STARS-Design-Track-2023/MatrixMonSTARS/docs/pdfs/OpcodeDecoder.drawio.pdf

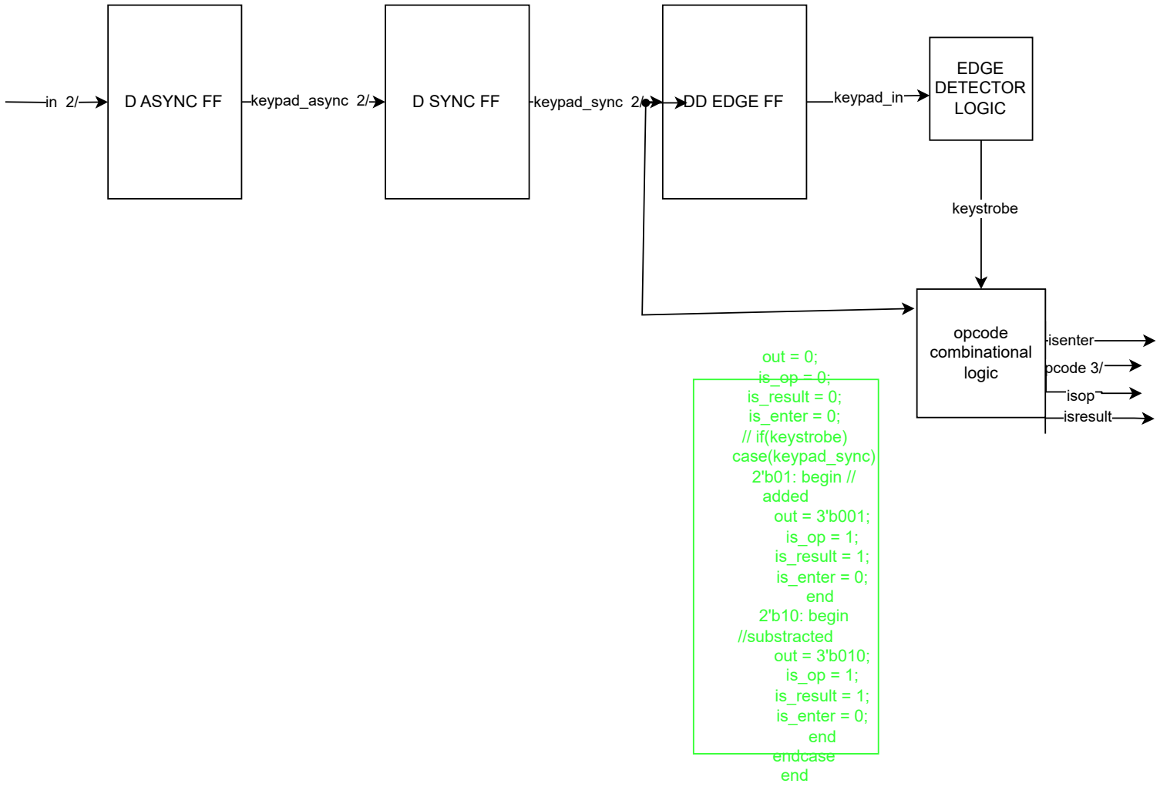
[picture p5: figure]
D ASYNC FF; keypad_async 2/; D SYNC FF; keypad_sync 2/; DD EDGE FF; keypad_in; out = 0; is_op = 0; is_result = 0; is_enter = 0; // if(keystrobe) case(keypad_sync) 2'b01: begin // added out = 3'b001; is_op = 1; is_result = 1; is_enter = 0; end 2'b10: begin //substracted out = 3'b010; is_op = 1; is_result = 1; is_enter = 0; end endcase end; opcode 3/; isop isresult; isenter opcode combinational logic; keystrobe; EDGE DETECTOR LOGIC
