STARS-Design-Track-2023/MatrixMonSTARS/docs/pdfs/ssdec.drawio.pdf

Seven Segment Decode Logic: case(msd)
4'b0000: begin
segments[13:7] =
7'b01

1

1

1

11;
end
4'b0001: begin segments[13:7] = 7'b0000110;
end
4'b0010: begin segments[13:7] = 7'b1011011;
end
4'b0011: begin segments[13:7] = 7'b1001

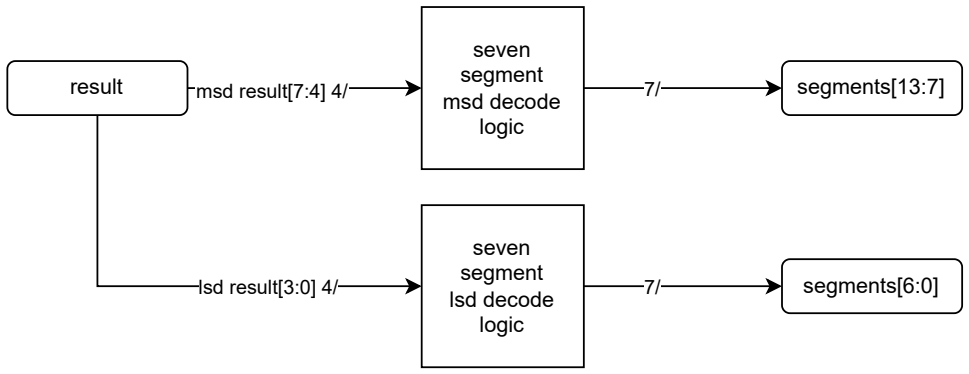
[picture p6: figure]
seven segment msd decode logic; msd result[7:4] 4/ result; segments[13:7]; seven segment lsd decode logic; lsd result[3:0] 4/; segments[6:0]

1

11;
end
4'b0100: begin segments[13:7] = 7'b1100110;
end
4'b0101: begin segments[13:7] = 7'b1101101;
end
4'b0110: begin segments[13:7] = 7'b1

1

1

1101;
end
4'b01

11: begin segments[13:7]
= 7'b00001

11;
end
4'b1000: begin segments[13:7] = 7'b1

1

1

1

1

11;
end
4'b1001: begin segments[13:7] = 7'b1101

1

11;
end
default: begin segments[13:7] = 7'b0;
end
endcase

Note: Although the least
significant digit is not shown here. The cases are identical
