STARS-Design-Track-2023/MatrixMonSTARS/docs/manual.pdf

# Setting up the Calculator

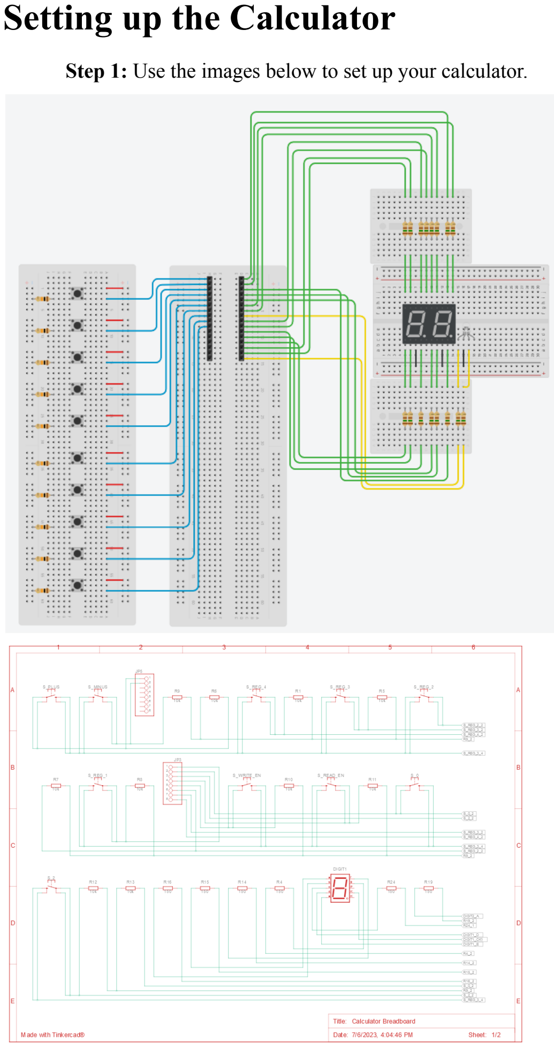
[picture p7: page 1]

Step 1: Use the images below to set up your calculator.

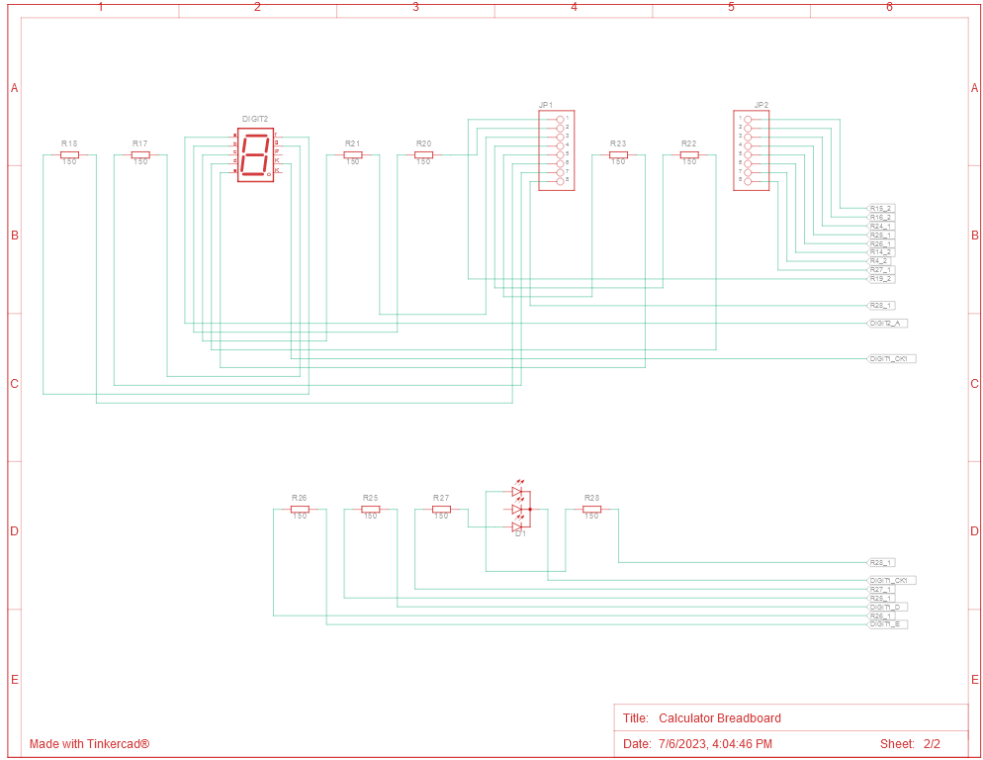
[picture p8: figure]

# How To Use the Calculator

This Calculator only supports 1 and 0s as inputs. All inputs must be in the form of a binary coded decimal (BCD). The BCD and decimal equivalent are listed below:

0 --> 000000000 | 1 --> 000000001 | 2 --> 000000010 | 3 --> 000000011
4 --> 000000100 | 5 --> 000000101 | 6 --> 000000110 | 7 --> 000000111
8 --> 000001000 | 9 --> 000011001 | 10 --> 000010000 | 11 --> 000010001
12 --> 000010010 | 13 --> 000010011 | 14 --> 000010100 | 15 --> 000010101
16 --> 000010110 | 17 --> 000010111 | 18 --> 000011000 | 19 --> 000101001
20 --> 000100000 | 21 --> 000100001 | 22 --> 000100010 | 23 --> 000100011
24 --> 000100100 | 25 --> 000100101 | 26 --> 000100110 | 27 --> 000100111
28 --> 000101000 | 29 --> 000111001 | 30 --> 000110000 | 31 --> 000110001
32 --> 000110010 | 33 --> 000110011 | 34 --> 000110100 | 35 --> 000110101
76 --> 001110110 | 77 --> 001110111 | 78 --> 001111000 | 79 --> 010001001
80 --> 010000000 | 81 --> 010000001 | 82 --> 010000010 | 83 --> 010000011
84 --> 010000100 | 85 --> 010000101 | 86 --> 010000110 | 87 --> 010000111
88 --> 010001000 | 89 --> 010011001 | 90 --> 010010000 | 91 --> 010010001
92 --> 010010010 | 93 --> 010010011 | 94 --> 010010100 | 95 --> 010010101
96 --> 010010110 | 97 --> 010010111 | 98 --> 010011000 | 99 --> 010011001
-100 --> 100000000 -99 --> 100000001 | -98 --> 100000010 | -97 --> 100000011
-96 --> 100000100 | -95 --> 100000101 | -94 --> 100000110 | -93 --> 100000111
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

Step 1: Entering the numbers into the calculator
When you first power up the calculator, you will need to press the enable button to start the process of writing the BCD values into the calculator’s memory. The write enable button is shown in the image below.

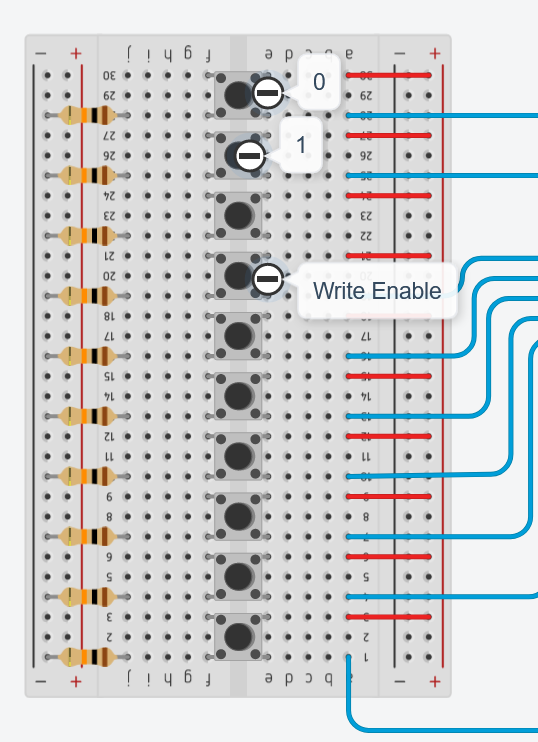
[picture p9: figure]

When the write enable has been pressed, enter your number using the 0 and 1 button. If the number you entered shows up on the seven segment displays, you have done it correctly. If you get an unexpected display, you may have made a mistake. If you have, please restart the calculator and start Step 1 again.

Step 2: Storing the numbers
This calculator has a register file that can store up to four digits. To store a number press any of the four registers. Note: Any value that is currently stored in the register will be overwritten with the most recent value entered. The register buttons are shown in the image below. You do not need to fill all the registers. You only need at least two to make calculations.

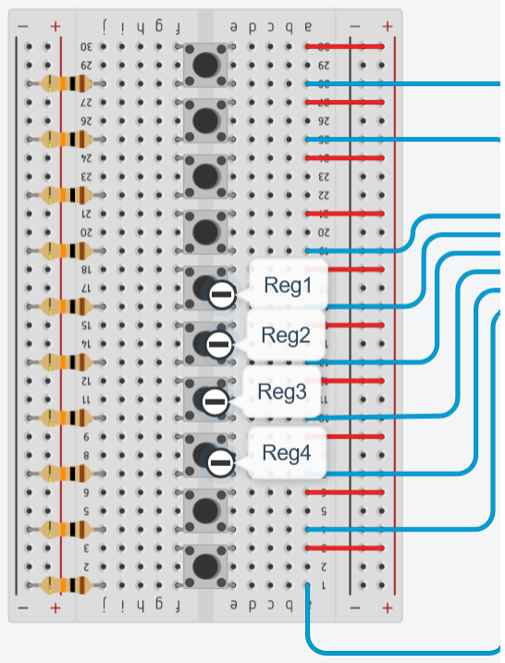
[picture p10: figure]

Step 3: Doing the calculation
When you have finished storing the numbers, to do the calculation, press the read enable button. This enables the calculator to read values from the shift register. When you have pressed the read enable button, select any two values by pressing the register buttons you would like to calculate. When you have done so, simply press the addition or subtraction button to get your calculations. The relevant buttons are shown in the image below.

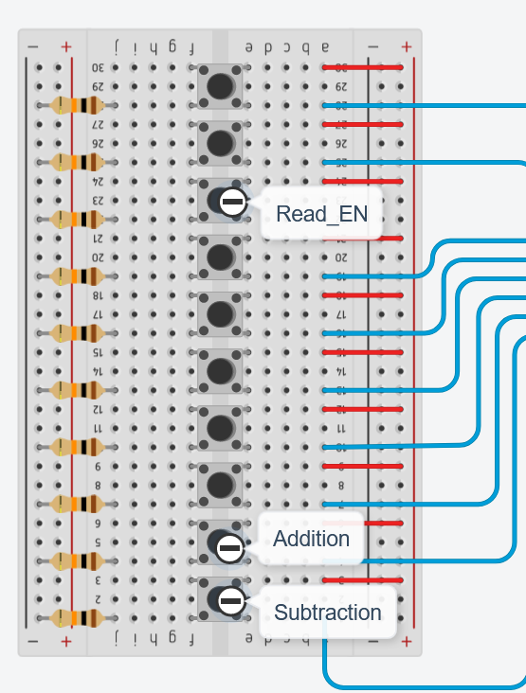
[picture p11: figure]

# Making Another Calculation Using Values Entered

If you have entered four values and you want to make a calculation using those numbers simply repeat Step 3 after you get your result.

# Entering New Numbers

To enter new numbers, simply press the write enable button and start from Step 1.
