STARS-Design-Track-2023/MatrixMonSTARS/docs/pdfs/readFSM.drawio-1.pdf

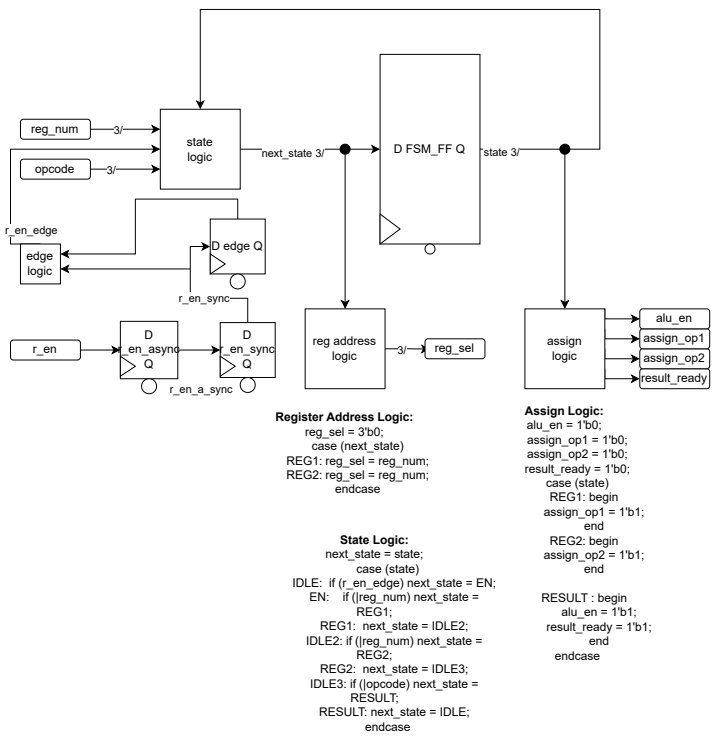
[picture p12: page 1]
state logic; D FSM_FF Q; state 3/; assign logic; result_ready; assign_op2; assign_op1; alu_en; reg address logic; next_state 3/; reg_sel; opcode; reg_num; State Logic: next_state = state; case (state); REG1; REG1: next_state = IDLE2; IDLE2: if (|reg_num) next_state = REG2; REG2: next_state = IDLE3; IDLE3: if (|opcode) next_state = RESULT; RESULT: next_state = IDLE; endcase; Register Address Logic: reg_sel = 3'b0; case (next_state) REG1: reg_sel = reg_num; REG2: reg_sel = reg_num; endcase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

IDLE: if (r_en_edge) next_state = EN;
EN: if (|reg_num) next_state =
