STARS-Design-Track-2023/MatrixMonSTARS/docs/pdfs/Reg_Decoder.drawio.pdf

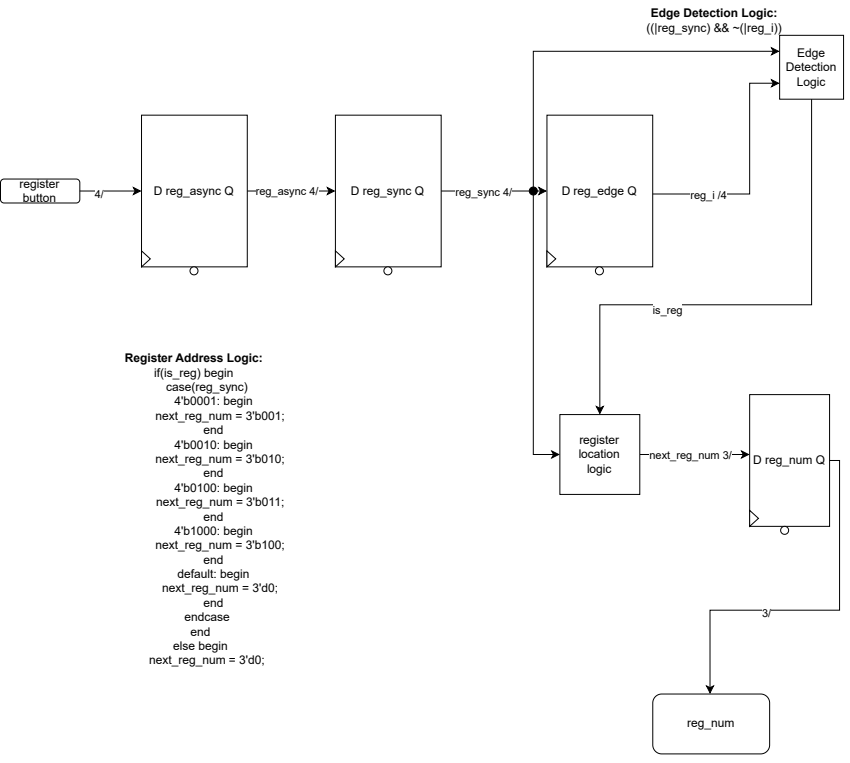
[picture p13: page 1]
register; button; D reg_async Q; reg_async 4/; D reg_sync Q; reg_sync 4/; D reg_edge Q; is_reg; Edge Detection Logic; reg_i /4; next_reg_num 3/; register location logic; D reg_num Q; reg_num; Register Address Logic: if(is_reg) begin case(reg_sync) 4'b0001: begin next_reg_num = 3'b001; end 4'b0010: begin next_reg_num = 3'b010; end 4'b0100: begin next_reg_num = 3'b011; end 4'b1000: begin next_reg_num = 3'b100; end default: begin next_reg_num = 3'd0; end endcase end else begin next_reg_num = 3'd0;

Edge Detection Logic:
((|reg_sync) && ~(|reg_i))
