STARS-Design-Track-2023/MatrixMonSTARS/docs/pdfs/Top Module.drawio.pdf

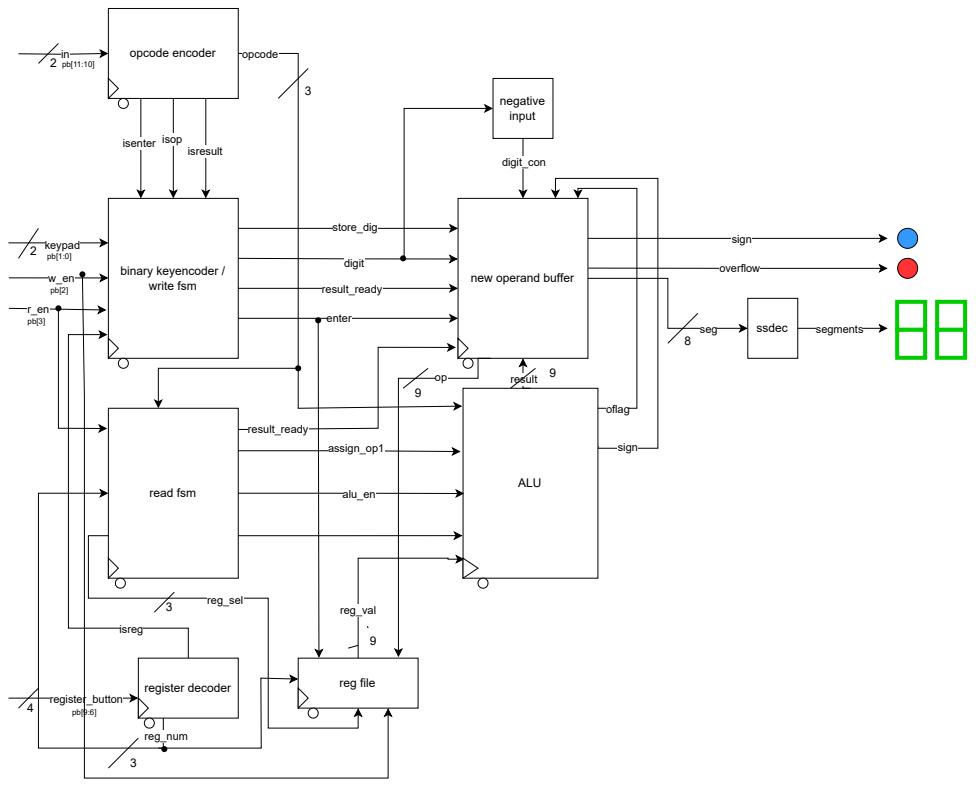
[picture p14: page 1]
store_dig; result_ready; negative input; isop isenter; isresult; opcode encoder; opcode; sign; enter; digit_con; reg_num; isreg; register decoder; reg file; read fsm; reg_sel; oflag; ALU; result; reg_val; alu_en; assign_op1; ssdec; segments; keypad; seg; register_button; overflow

digit binary keyencoder /
write fsm

new operand buffer
