STARS-Design-Track-2023/MatrixMonSTARS/docs/pdfs/NewOperandBuffer.drawio.pdf

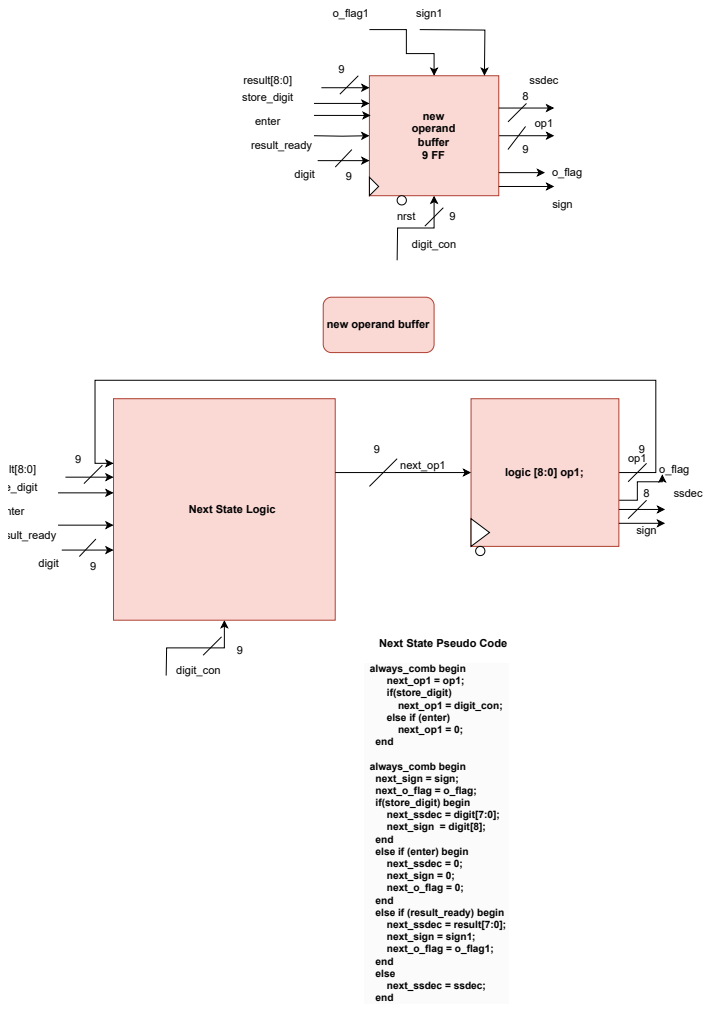
[picture p17: page 1]
new operand buffer 9 FF; digit; nrst; store_digit; result_ready; logic [8:0] op1;; next_op1; result[8:0]; sign; enter; ssdec; o_flag1; sign1; o_flag; e_digit; sult_ready; nter; digit_con; always_comb begin next_op1 = op1; if(store_digit) next_op1 = digit_con; else if (enter) next_op1 = 0;; end; always_comb begin next_sign = sign; next_o_flag = o_flag; if(store_digit) begin next_ssdec = digit[7:0]; next_sign = digit[8]; end else if (enter) begin next_ssdec = 0; next_sign = 0; next_o_flag = 0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

new operand buffer

Next State Logic

Next State Pseudo Code
