STARS-Design-Track-2023/MatrixMonSTARS/docs/pdfs/readFSM_State_Transision.drawio.pdf

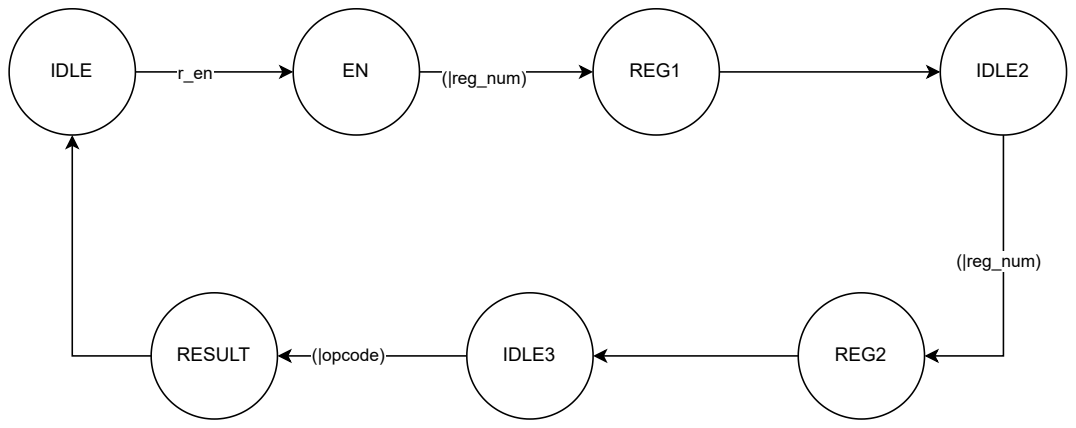
[picture p18: page 1]
IDLE; (|reg_num) EN; REG1; (|reg_num); IDLE2; RESULT; (|opcode); IDLE3; REG2
