STARS-Design-Track-2023/MatrixMonSTARS/docs/pdfs/reg_file.drawio.pdf

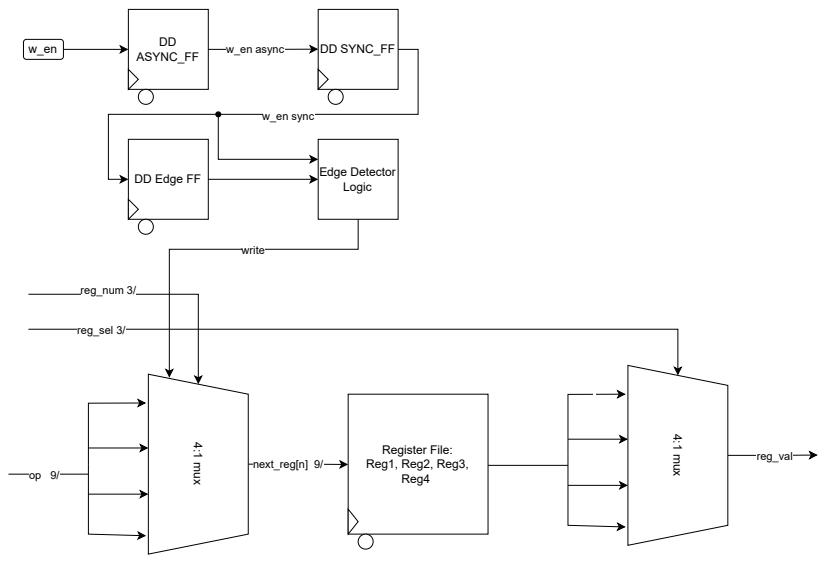
[picture p19: page 1]
next_reg[n] 9/; 4:1 mux; reg_num 3/; Register File: Reg1, Reg2, Reg3, Reg4; reg_val; write; w_en async; DD ASYNC_FF w_en; w_en sync; DD SYNC_FF; DD Edge FF; Edge Detector; Logic; reg_sel 3/
