STARS-Design-Track-2023/MatrixMonSTARS/docs/pdfs/State_Transision_Diagram_ReadFSM.drawio.pdf

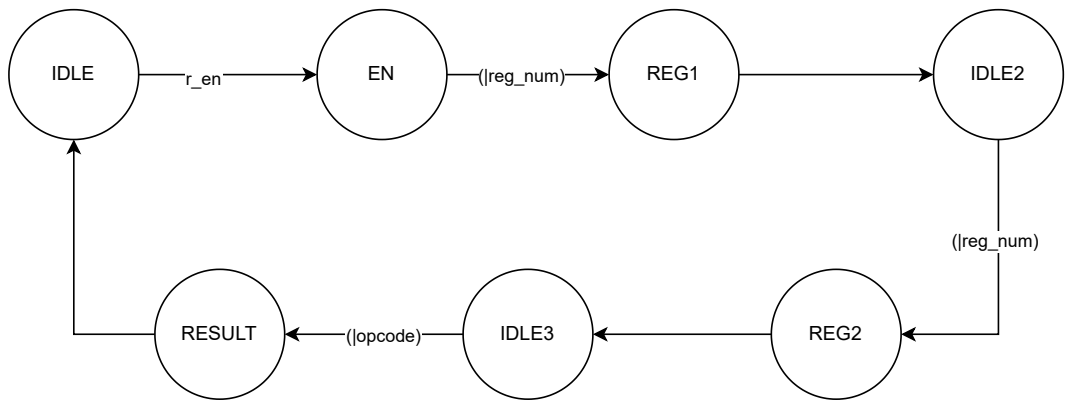
[picture p20: page 1]
IDLE; (|reg_num); REG1; IDLE2; RESULT; (|opcode); IDLE3; REG2
