STARS-Design-Track-2023/MatrixMonSTARS/docs/pdfs/StateTransisionKeyencoder.drawio.pdf

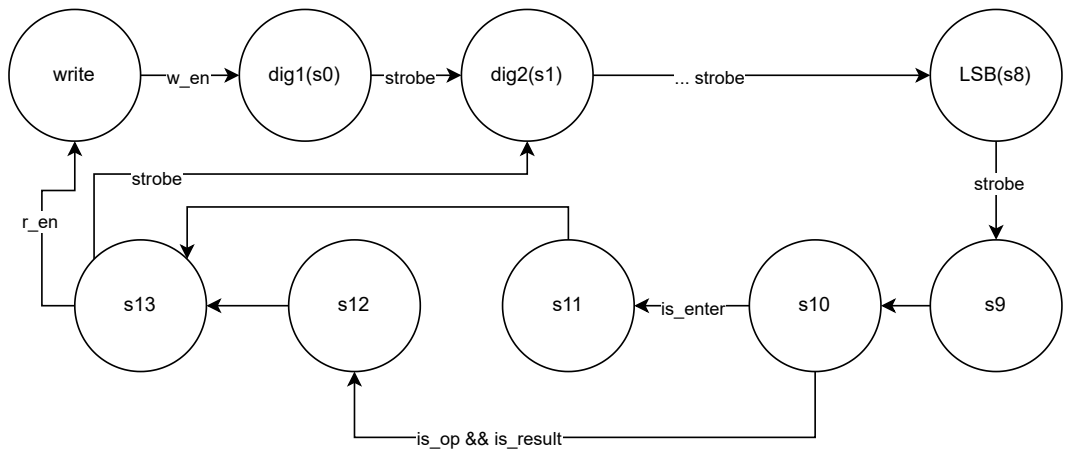
[picture p21: page 1]
write; dig1(s0); strobe; dig2(s1); ... strobe; LSB(s8); is_enter; is_op && is_result
