STARS-Design-Track-2023/MatrixMonSTARS/docs/pdfs/WriteEncoderFSM.drawio-2.pdf

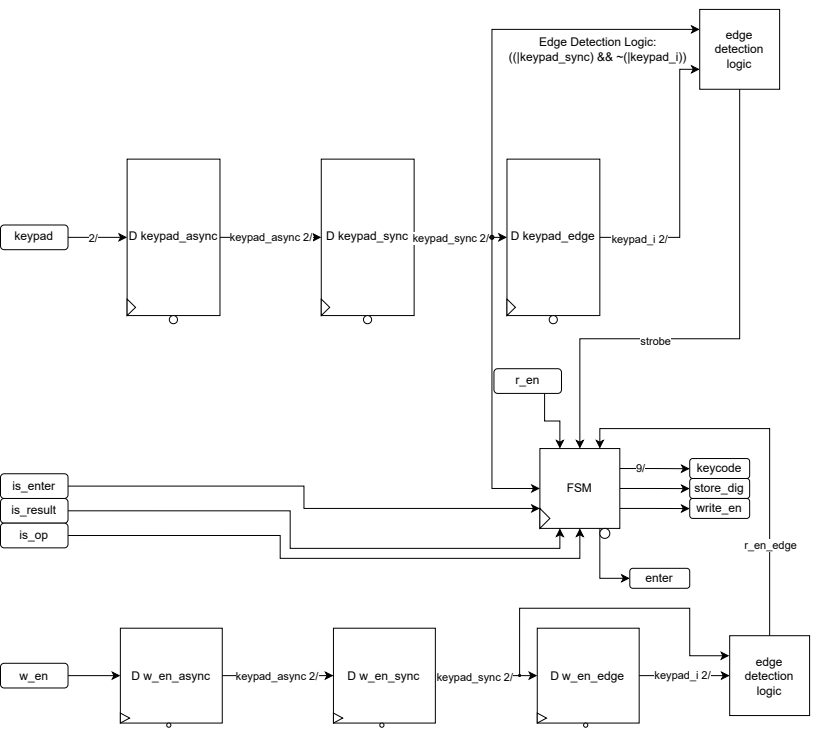
[picture p22: page 1]
keypad; D keypad_async; keypad_async 2/; D keypad_sync; keypad_sync 2/; D keypad_edge; keypad_i 2/; strobe; edge detection logic; FSM; keycode; store_dig; write_en; enter; is_result; is_enter; r_en_edge; D w_en_async; D w_en_sync; D w_en_edge

Edge Detection Logic:
((|keypad_sync) && ~(|keypad_i))
