STARS-Design-Track-2023/MatrixMonSTARS/synthesis/calculator.v

module calculator (VGND,
    VPWR,
    blue,
    clk,
    nrst,
    red,
    pb,
    ss);
 input VGND;
 input VPWR;
 output blue;
 input clk;
 input nrst;
 output red;
 input [9:0] pb;
 output [13:0] ss;

 wire _0000_;
 wire _0001_;
 wire _0002_;
 wire _0003_;
 wire _0004_;
 wire _0005_;
 wire _0006_;
 wire _0007_;
 wire _0008_;
 wire _0009_;
 wire _0010_;
 wire _0011_;
 wire _0012_;
 wire _0013_;
 wire _0014_;
 wire _0015_;
 wire _0016_;
 wire _0017_;
 wire _0018_;
 wire _0019_;
 wire _0020_;
 wire _0021_;
 wire _0022_;
 wire _0023_;
 wire _0024_;
 wire _0025_;
 wire _0026_;
 wire _0027_;
 wire _0028_;
 wire _0029_;
 wire _0030_;
 wire _0031_;
 wire _0032_;
 wire _0033_;
 wire _0034_;
 wire _0035_;
 wire _0036_;
 wire _0037_;
 wire _0038_;
 wire _0039_;
 wire _0040_;
 wire _0041_;
 wire _0042_;
 wire _0043_;
 wire _0044_;
 wire _0045_;
 wire _0046_;
 wire _0047_;
 wire _0048_;
 wire _0049_;
 wire _0050_;
 wire _0051_;
 wire _0052_;
 wire _0053_;
 wire _0054_;
 wire _0055_;
 wire _0056_;
 wire _0057_;
 wire _0058_;
 wire _0059_;
 wire _0060_;
 wire _0061_;
 wire _0062_;
 wire _0063_;
 wire _0064_;
 wire _0065_;
 wire _0066_;
 wire _0067_;
 wire _0068_;
 wire _0069_;
 wire _0070_;
 wire _0071_;
 wire _0072_;
 wire _0073_;
 wire _0074_;
 wire _0075_;
 wire _0076_;
 wire _0077_;
 wire _0078_;
 wire _0079_;
 wire _0080_;
 wire _0081_;
 wire _0082_;
 wire _0083_;
 wire _0084_;
 wire _0085_;
 wire _0086_;
 wire _0087_;
 wire _0088_;
 wire _0089_;
 wire _0090_;
 wire _0091_;
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
 sky130_fd_sc_hd__tapvpwrvgnd_1 TAP_190 (.VGND(VGND),
    .VPWR(VPWR));
 sky130_fd_sc_hd__tapvpwrvgnd_1 TAP_191 (.VGND(VGND),
    .VPWR(VPWR));
 sky130_fd_sc_hd__tapvpwrvgnd_1 TAP_192 (.VGND(VGND),
    .VPWR(VPWR));
 sky130_fd_sc_hd__tapvpwrvgnd_1 TAP_193 (.VGND(VGND),
    .VPWR(VPWR));
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
