STARS-Design-Track-2023/MatrixMonSTARS/(commit log)

2023-06-22 encoder and digit decoder
2023-06-23 added reset press continuous test case
2023-06-28 fixed warning messages given by verilator
    [register_decoder.sv]
2023-06-28 pre final prototype
2023-06-28 binary encoder and FSM completed
2023-06-29 Mistakenly put neg_input.sv outside of source
    [neg_input.sv]
2023-06-29 Completed Register_Calculator
    Updated all edits made. Inserted calculator.sv file for final phase
2023-06-30 fixed some width errors
    [alu.sv, opcode_encoder.sv]
2023-07-04 Added top tb and fix bugs
    [keyencoder_binary.sv, opcode_encoder.sv, read_fsm.sv, sync_edge_detector.sv, tb_calculator.v]
2023-07-04 Replace stop with finish
    [tb_calculator.v]
2023-07-04 Change datatype to wire
2023-07-04 Added resistors to breadboad diagram. Change setup help and equipment required
2023-07-08 add gds sdf synthesis
    [calculator.sdf]
